sawaYch/tamagotchi-paradise-rechargeable/docs/20261008_042107.jpg

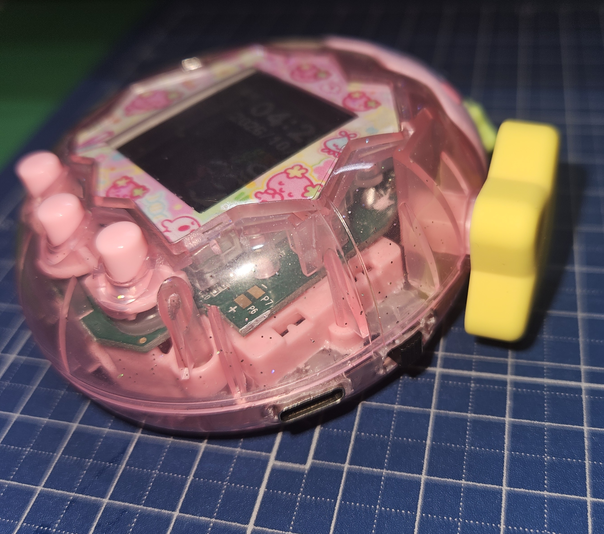
docs/20261008_042107.jpg
