sawaYch/tamagotchi-paradise-rechargeable/tama_power_path/tama_power_path_pcb.png

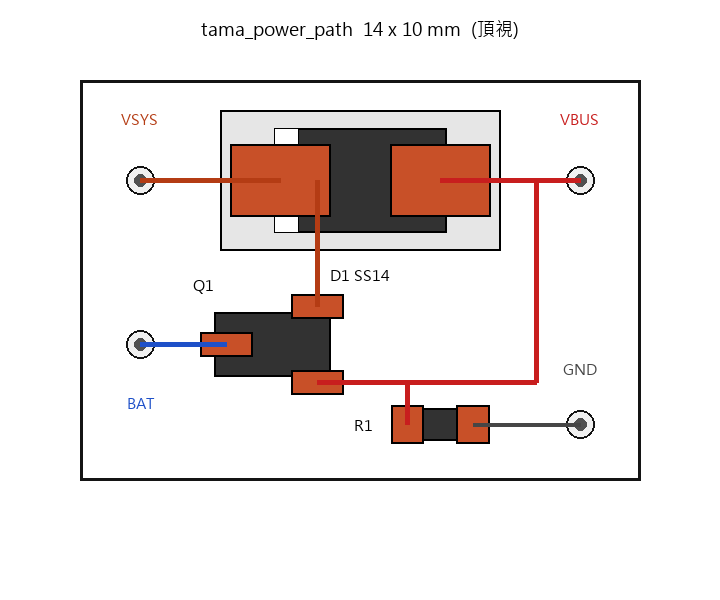
tama_power_path/tama_power_path_pcb.png
