sawaYch/tamagotchi-paradise-rechargeable/tama_power_path/tama_power_path_sch.png

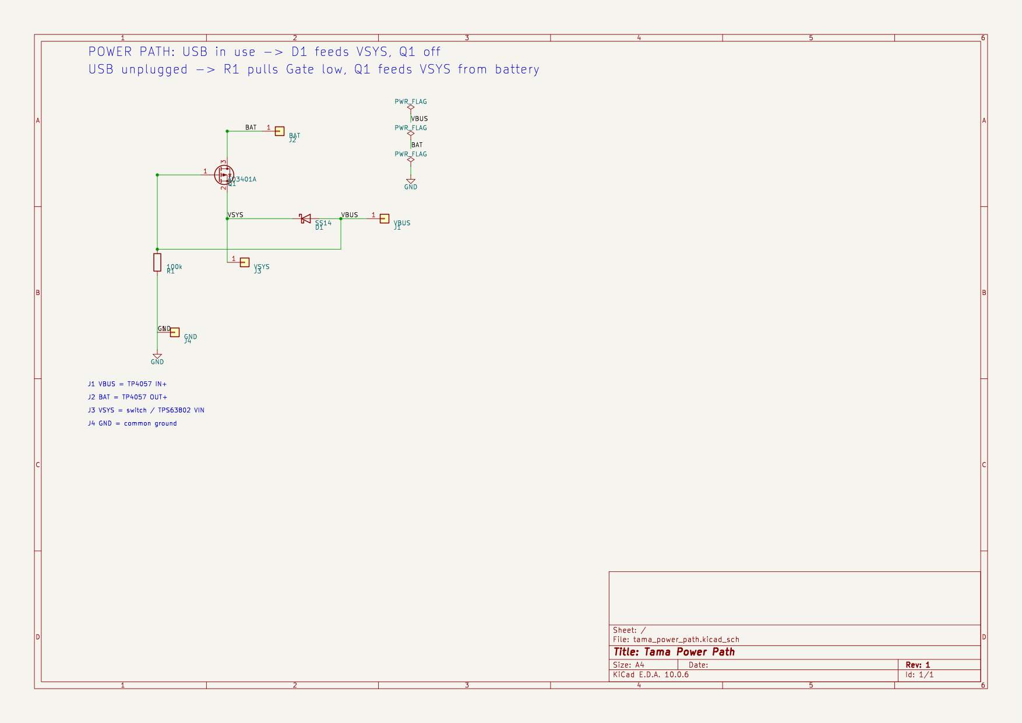
tama_power_path/tama_power_path_sch.png
