sawaYch/tamagotchi-paradise-rechargeable/tama_power_path/fab/tama_power_path_bom.csv

Comment | Designator | Footprint | LCSC Part #
SS14 | D1 | D_SMA | C2480
AO3401A | Q1 | SOT-23 | C15127
100k | R1 | R_0603_1608Metric | C25803
