sawaYch/tamagotchi-paradise-rechargeable/tama_power_path/tama_power_path.kicad_pcb

## KiCad design tama_power_path/tama_power_path.kicad_pcb (2026-10-20)

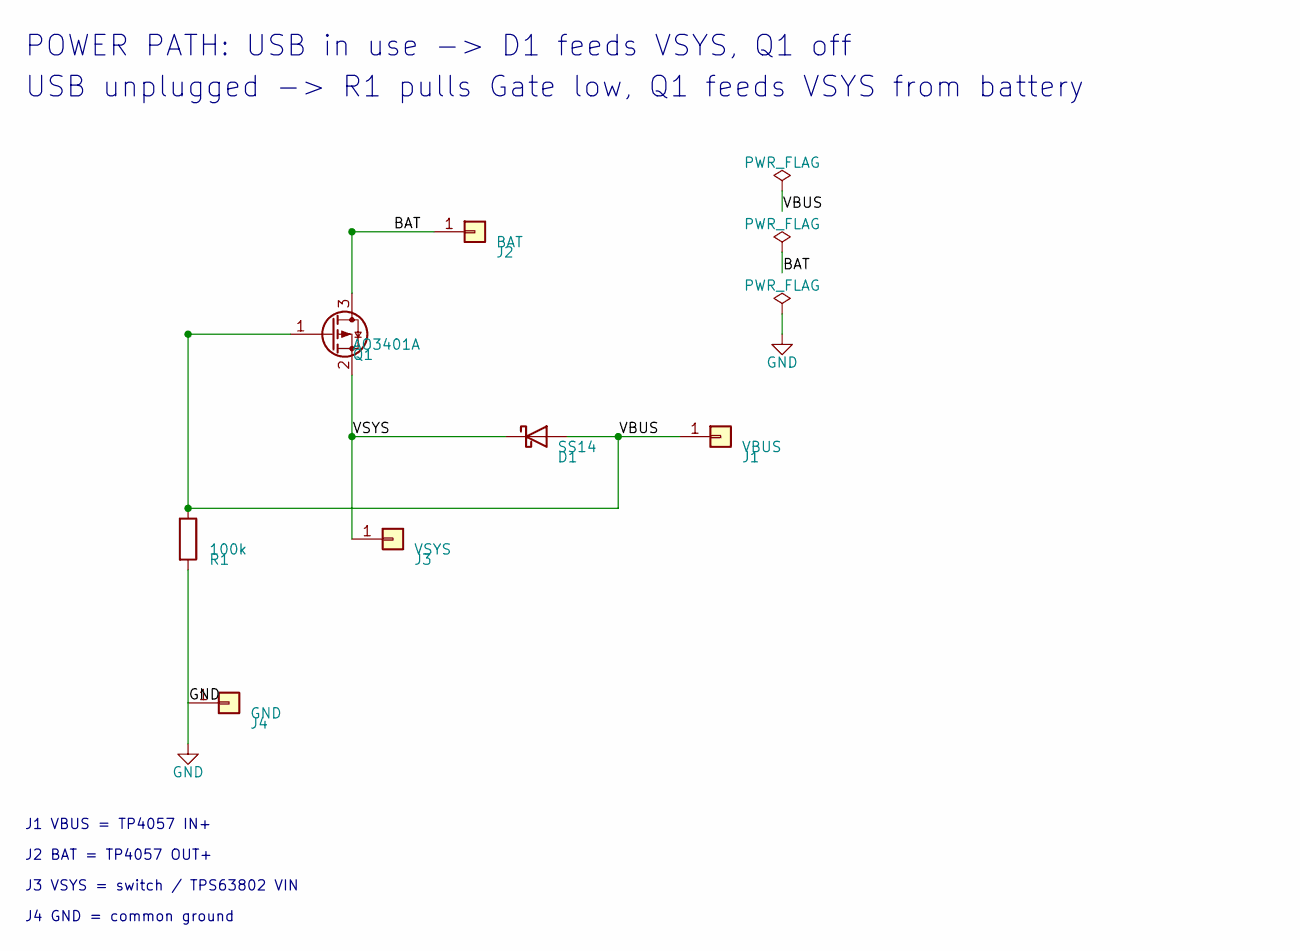
[picture p10: schematic tama_power_path.kicad_sch, Tama Power Path]

Parts:
D1: SS14; D_SMA; LCSC C2480
J1: VBUS; WirePads_1x01
J2: BAT; WirePads_1x01
J3: VSYS; WirePads_1x01
J4: GND; WirePads_1x01
Q1: AO3401A; SOT-23; LCSC C15127
R1: 100k; R_0603_1608Metric; LCSC C25803

Connections:
BAT: J2.1, Q1.3 (D)
GND: J4.1, R1.2
VBUS: D1.2 (A), J1.1, Q1.1 (G), R1.1
VSYS: D1.1 (K), J3.1, Q1.2 (S)

Notes on the sheet:
POWER PATH: USB in use -> D1 feeds VSYS, Q1 off
USB unplugged -> R1 pulls Gate low, Q1 feeds VSYS from battery
J1 VBUS = TP4057 IN+
J2 BAT = TP4057 OUT+
J3 VSYS = switch / TPS63802 VIN
J4 GND = common ground

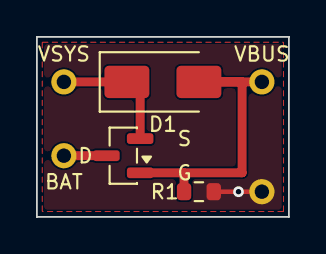
[picture p11: board tama_power_path.kicad_pcb from above]

Board: 2 copper layers, 14.0 x 10.0 mm, 7 parts (0 on the bottom side), 4 nets.
