sawaYch/tamagotchi-paradise-rechargeable/docs/20261008_030610.jpg

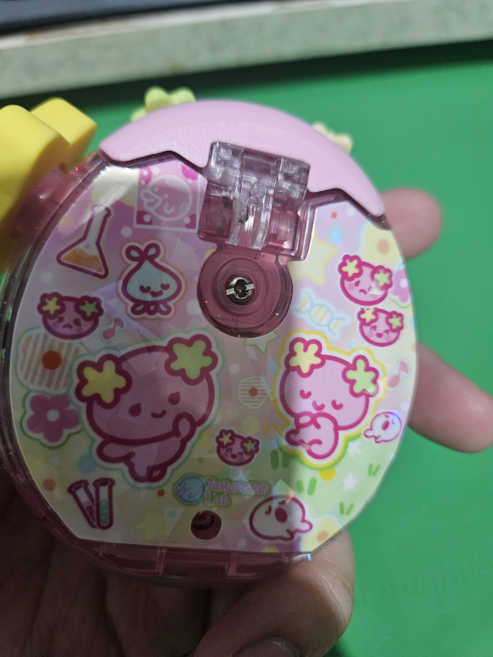
docs/20261008_030610.jpg
