sawaYch/tamagotchi-paradise-rechargeable/docs/20261008_030651.jpg

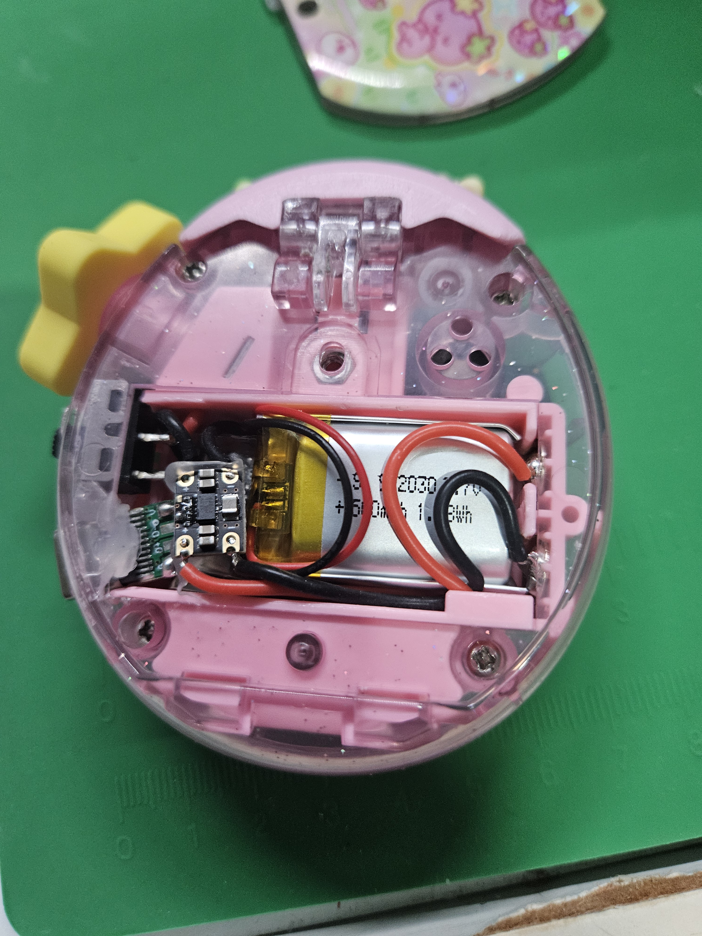
[picture p2: docs/20261008_030651.jpg]
docs/20261008_030651.jpg
