sawaYch/tamagotchi-paradise-rechargeable/docs/20261008_035104.jpg

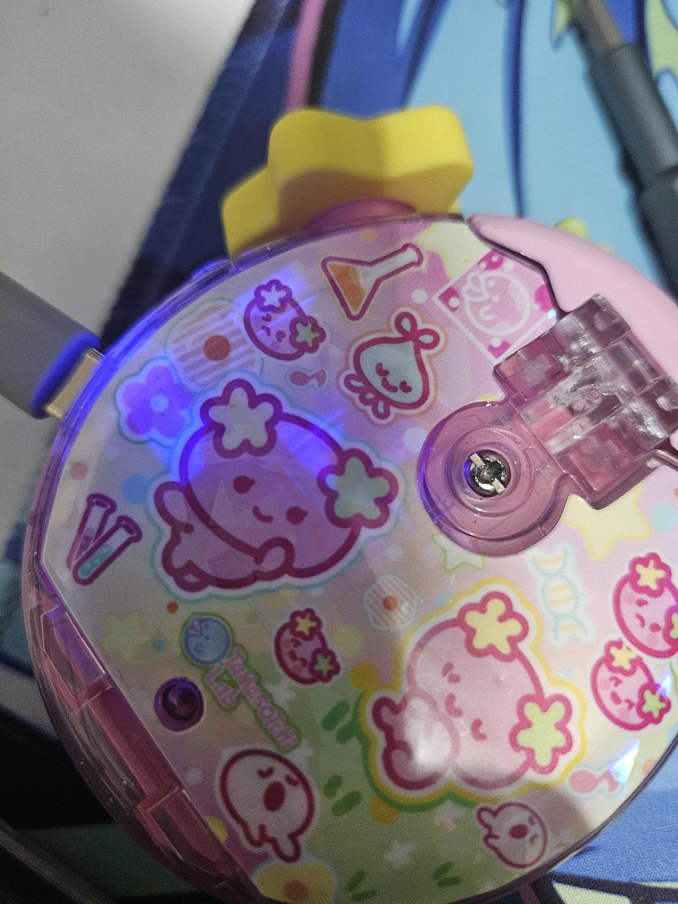
[picture p5: docs/20261008_035104.jpg]
docs/20261008_035104.jpg
